ha-zhuzhu/SmartDiet/Device/Schematic/BOM.xlsx

Item | Quantity | Reference | Value | PCB Footprint
1 | 4 | C1,C2,C30,C32 | 10u | C0805_rola
2 | 6 | C3,C4,C29,C31,C34,C38 | 0.1u | C0805_rola
3 | 4 | C7,C8,C9,C10 | 30p | C0805_rola
4 | 6 | C11,C24,C27,C28,C36,C37 | 100n | C0805_rola
5 | 2 | C19,C20 | 12p | C0805_rola
6 | 2 | C21,C33 | 1n | C0805_rola
7 | 2 | C22,C23 | 20p | C0805_rola
8 | 3 | C25,C39,C40 | 1u | C0805_rola
9 | 3 | D1,D2,D4 | SK14 | DO214
10 | 1 | D3 | RED | led_3mm_rola
11 | 1 | J1 | CON6 | hdr_1x6_rola
12 | 1 | J2 | 20279-001E-01 | IPEX_20279-001E-01
13 | 1 | J3 | MicroUSB | ZX62D-B-5P8_30__HIR
14 | 2 | J4,J7 | BAT | hdr_1x2_rola
15 | 1 | J5 | LCD | TE_103336-5
16 | 4 | J8,J9,J10,J11 | CON1 | mhole_32mm_rola
17 | 1 | J12 | CON6A | header_3x2_100mil
18 | 1 | L1 | Ferrite | R0805_rola
19 | 1 | Q1 | SS8550 | sot23_rola
20 | 1 | Q2 | SS8050 | sot23_rola
21 | 1 | Q3 | AO3401A | sot23_rola
22 | 1 | Q5 | AO3415 | sot23_rola
23 | 1 | R5 | 8.2k | R0805_rola
24 | 1 | R6 | 12k | R0805_rola
25 | 9 | R7,R18,R21,R28,R29,R30,R31,R32,R34 | 1k | R0805_rola
26 | 3 | R10,R12,R33 | 22 | R0805_rola
27 | 1 | R13 | 47k | R0805_rola
28 | 2 | R16,R27 | 10k | R0805_rola
29 | 1 | R17 | 51k | R0805_rola
30 | 3 | R19,R26,R35 | 100k | R0805_rola
31 | 1 | R22 | 33k | R0805_rola
32 | 2 | R23,R24 | 4.7k | R0805_rola
33 | 1 | R25 | 510k | R0805_rola
34 | 1 | R38 | 68k/NC | R0805_rola
35 | 1 | R39 | 300k/FB | R0805_rola
36 | 1 | R40 | 20k | R0805_rola
37 | 1 | R41 | 0 | R0805_rola
38 | 5 | R42,R43,R44,R45,R46 | NC | R0805_rola
39 | 1 | SIM1 | SIM_CARD | GCT_SIM7200-6-0-18-00-X_REV
40 | 1 | SW1 | SW PUSHBUTTON | pushbutton_rola
41 | 1 | SW2 | SW PUSHBUTTON | SW_1-1825027-1
42 | 1 | S1 | OS102011MS2QN1 | SW_OS102011MS2QN1
43 | 1 | U1 | HX711 | SOIC127P600X160-16N
44 | 1 | U2 | BC26 | BC26
45 | 1 | U5 | STM32L053C6 | LQFP48-7x7mm
46 | 1 | U6 | MP26028EQ | IC10_MP26028_MNP-L
47 | 1 | U9 | TPS7A2033PDBVR | DBV0005A-IPC_B
48 | 1 | Y1 | 8M | osc5032s2pin_rola
49 | 1 | Y2 | 32.768k | XTAL_ABS07-32768KHZ-T
50 | 1 |  | LCD
51 | 1 |  | 3kg悬臂梁式传感器
