ha-zhuzhu/SmartDiet/Device/Schematic/cyberbalance_3d_step_lib/USB3076-30-A--3DModel-STEP-56544.STEP

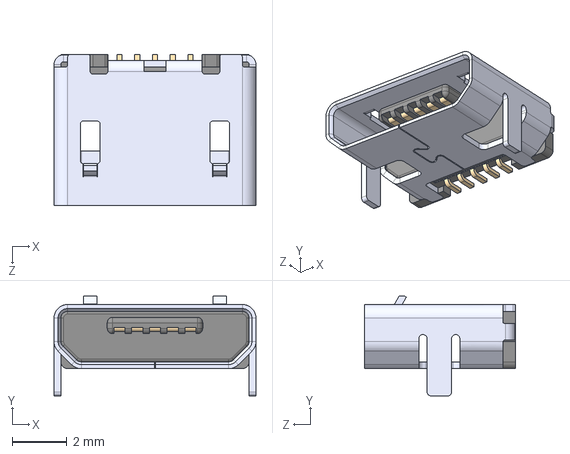
[picture p5: CAD file, 2021-05-22]
Device/Schematic/cyberbalance_3d_step_lib/USB3076-30-A--3DModel-STEP-56544.STEP
7.40 x 3.66 x 5.55 mm
