ha-zhuzhu/SmartDiet/(list of files, cad)

Other CAD files:
Device/Schematic/cyberbalance_footprint_lib/DO214.psm
Device/Schematic/cyberbalance_footprint_lib/bc26.psm
Device/Schematic/cyberbalance_footprint_lib/c0805_rola.psm
Device/Schematic/cyberbalance_footprint_lib/conn_5p8_30_.psm
Device/Schematic/cyberbalance_footprint_lib/dbv0005a-ipc_b.psm
Device/Schematic/cyberbalance_footprint_lib/gct_sim7200-6-0-18-00-x_rev.psm
Device/Schematic/cyberbalance_footprint_lib/gct_usb3076-xx-x_revc.psm
Device/Schematic/cyberbalance_footprint_lib/hdr_1x2_rola.psm
Device/Schematic/cyberbalance_footprint_lib/hdr_1x6_100mil.psm
Device/Schematic/cyberbalance_footprint_lib/hdr_1x6_rola.psm
Device/Schematic/cyberbalance_footprint_lib/hdr_2x3_100mil_th.psm
Device/Schematic/cyberbalance_footprint_lib/header_3x2_100mil.psm
Device/Schematic/cyberbalance_footprint_lib/hrs_zx62d-b-5p8.psm
Device/Schematic/cyberbalance_footprint_lib/ic10_mp26028_mnp-l.psm
Device/Schematic/cyberbalance_footprint_lib/ipex_20279-001e-01.psm
Device/Schematic/cyberbalance_footprint_lib/led_3mm_rola.psm
Device/Schematic/cyberbalance_footprint_lib/lqfp48-7x7mm.psm
Device/Schematic/cyberbalance_footprint_lib/mhfi_rece_ipx.psm
Device/Schematic/cyberbalance_footprint_lib/mhole_32mm_rola.psm
Device/Schematic/cyberbalance_footprint_lib/osc5032s2pin_rola.psm
Device/Schematic/cyberbalance_footprint_lib/pushbutton_rola.psm
Device/Schematic/cyberbalance_footprint_lib/r0805_rola.psm
Device/Schematic/cyberbalance_footprint_lib/samtec_rsp-122811-01.psm
Device/Schematic/cyberbalance_footprint_lib/soic127p600x160-16n.psm
Device/Schematic/cyberbalance_footprint_lib/sot23_6_rola.psm
Device/Schematic/cyberbalance_footprint_lib/sot23_rola.psm
Device/Schematic/cyberbalance_footprint_lib/sot95p275x135-6.psm
Device/Schematic/cyberbalance_footprint_lib/sw_1-1825027-1.psm
Device/Schematic/cyberbalance_footprint_lib/sw_os102011ms2qn1.psm
Device/Schematic/cyberbalance_footprint_lib/te_103336-5.psm
Device/Schematic/cyberbalance_footprint_lib/xtal_abs07-32768khz-t.psm
Device/Schematic/cyberbalance_footprint_lib/zx62d-b-5p8_30__hir.psm
