ha-zhuzhu/SmartDiet/Device/Schematic/allegro/stepFacetFiles4Map/stepFileInfo.txt

#STEP_FILE ! FILE_SIZE ! MOD_TIME

USB3076-30-A--3DModel-STEP-56544.STEP ! 1007054 ! 1620821139
507302B00000G--3DModel-STEP-56544.STEP ! 207014 ! 1568096060
