ha-zhuzhu/SmartDiet/Device/Schematic/PCB.pdf

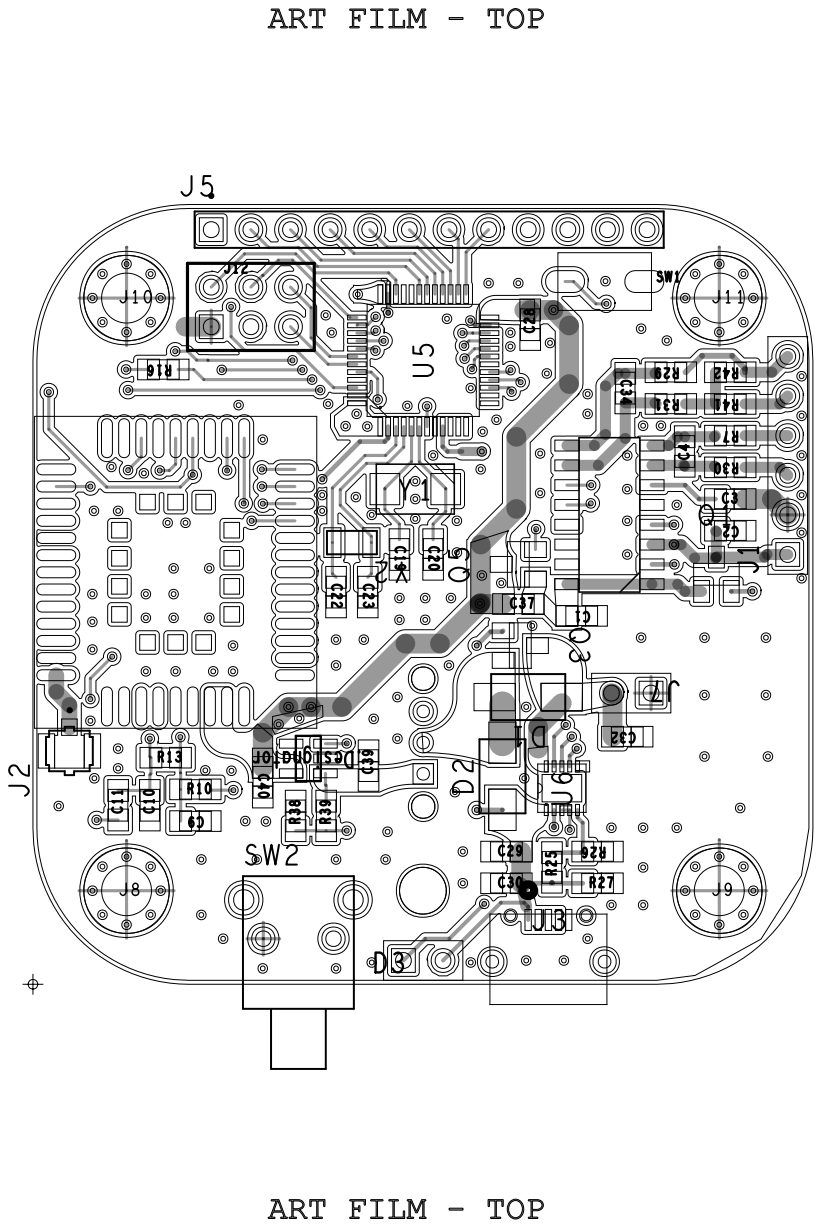
[picture p6: page 1]

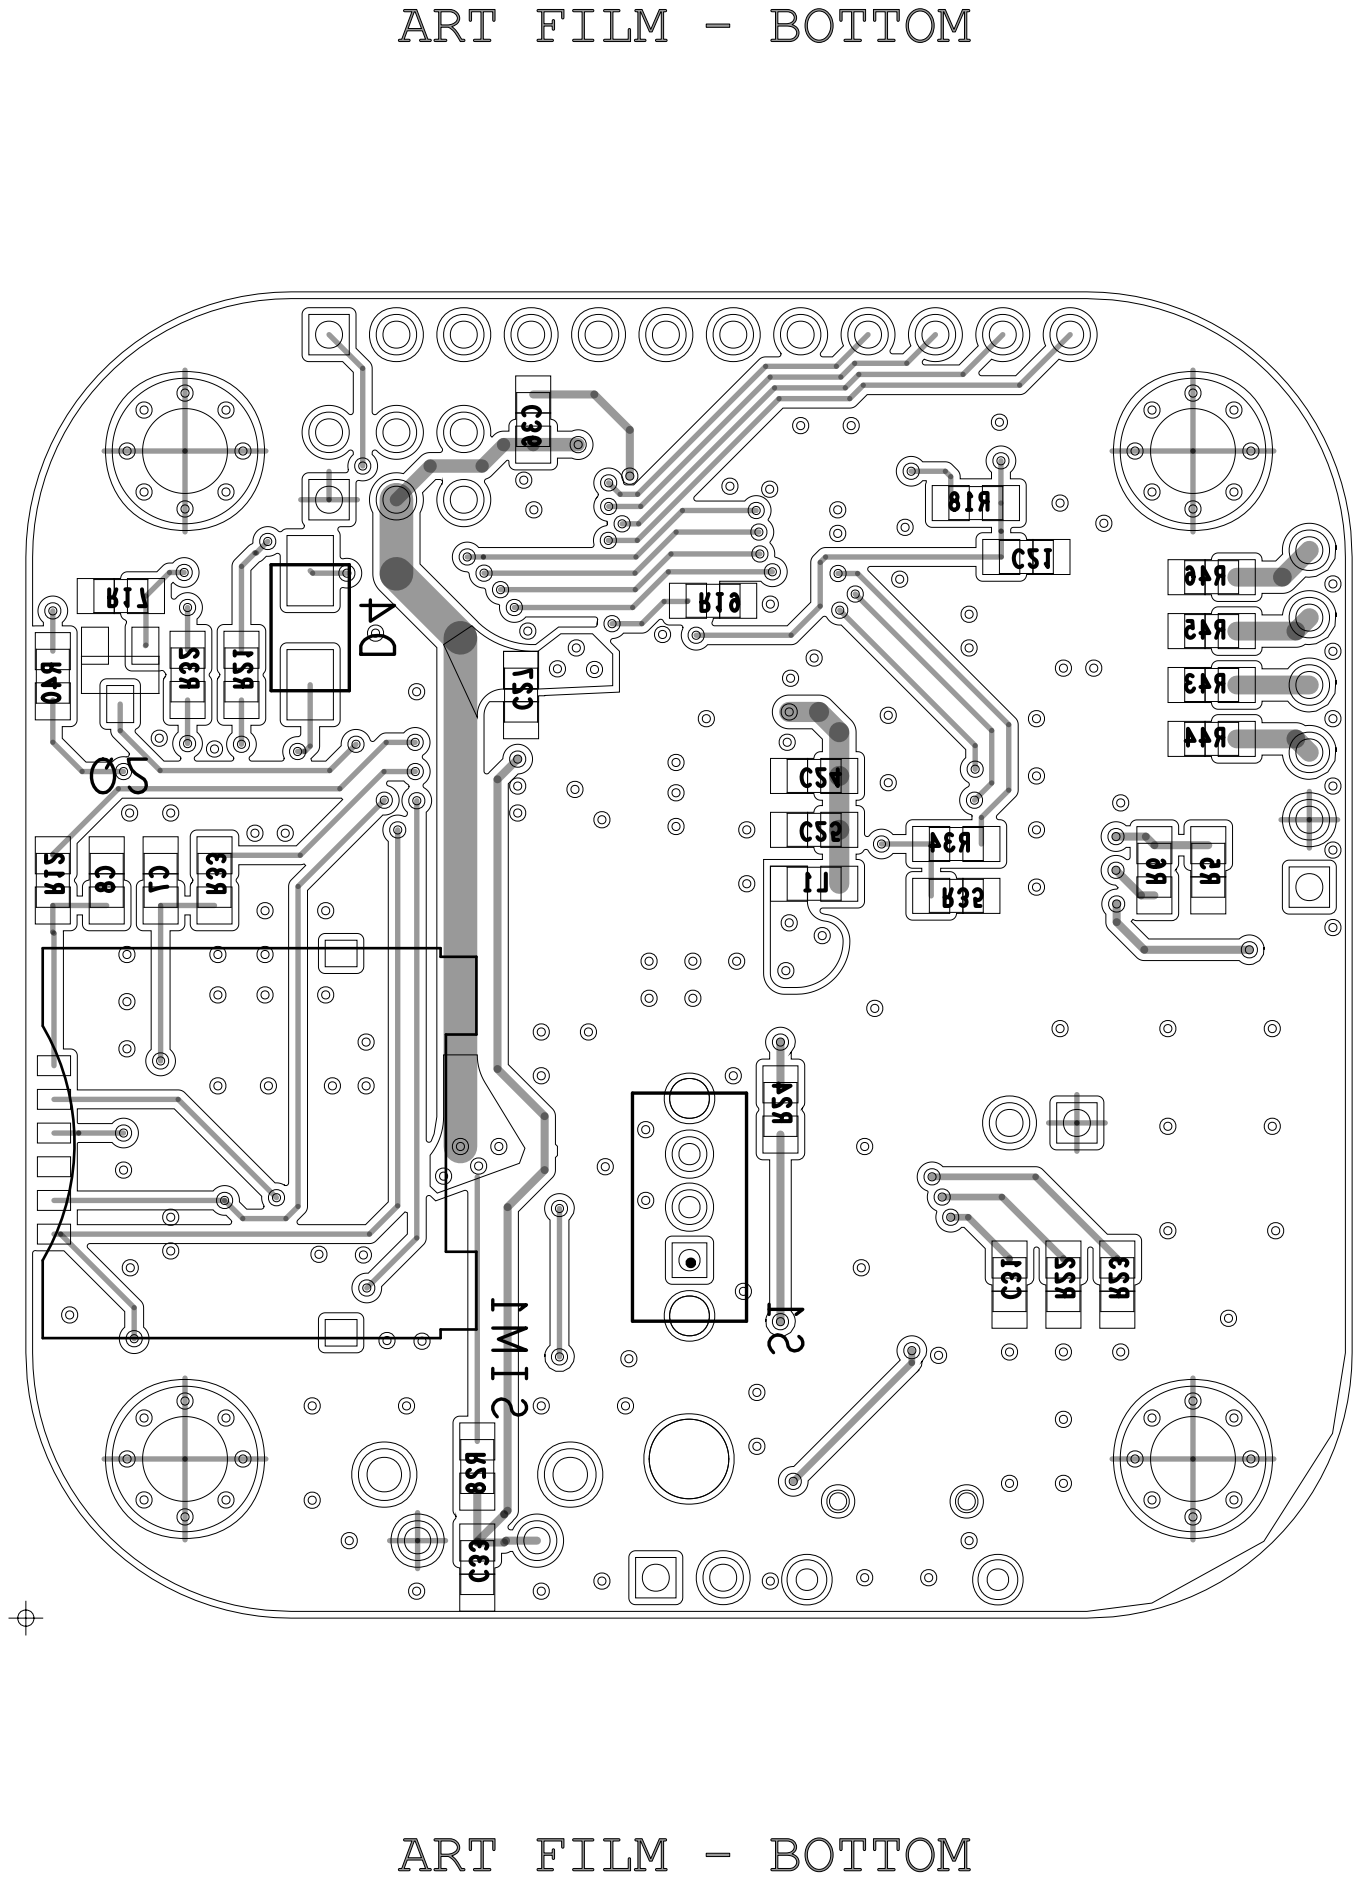
[picture p7: page 2]

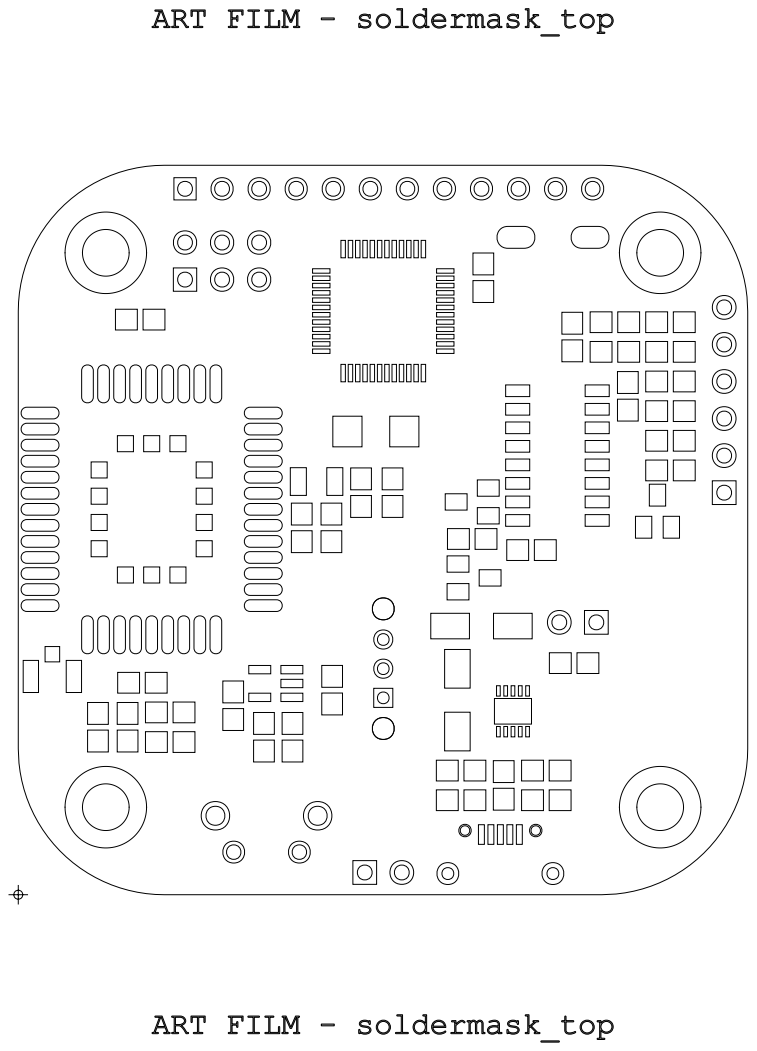
[picture p8: page 3]
ART FILM - soldermask_top

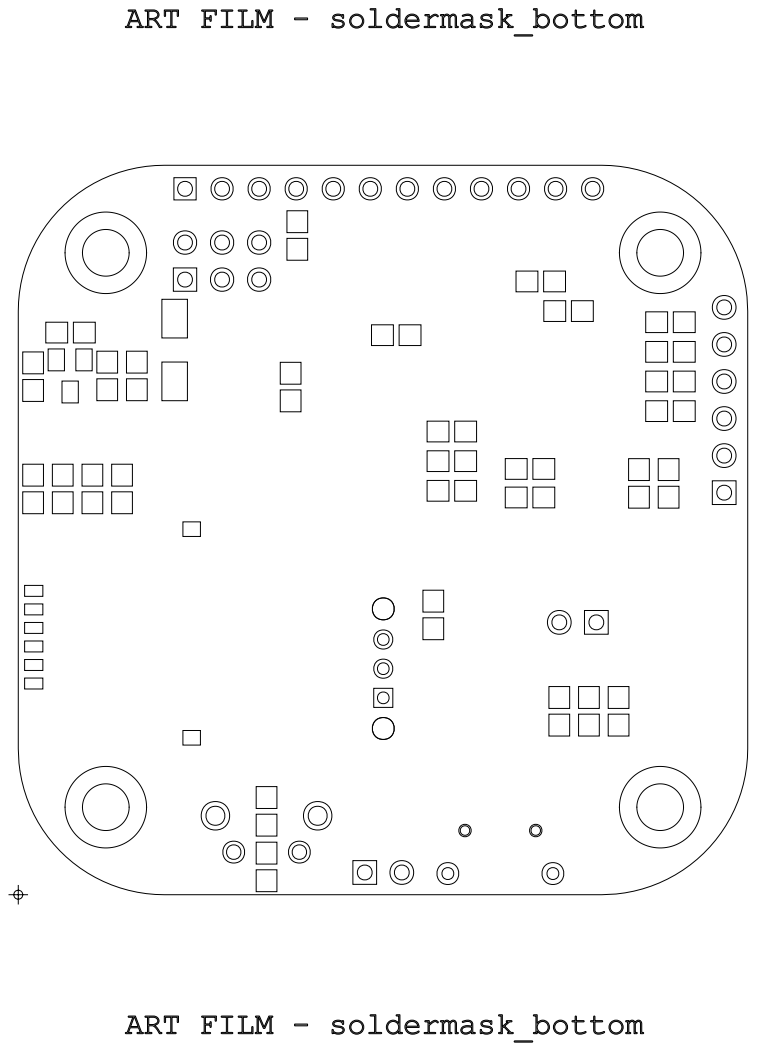
[picture p9: page 4]
ART FILM - soldermask_bottom

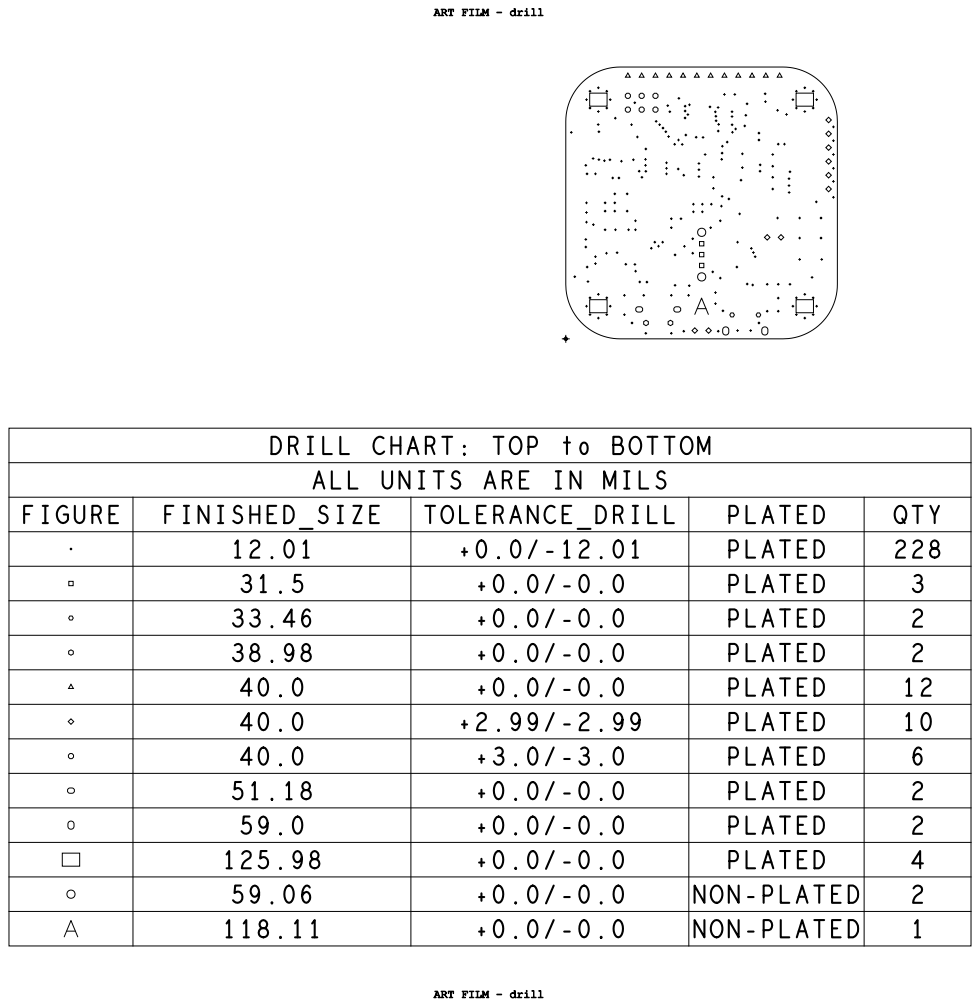
[picture p10: page 5]
FIGURE; FINISHED_SIZE; DRILL CHART:; TOP to BOTTOM; TOLERANCE_DRILL; NON-PLATED; PLATED; QTY

ART FILM - drill

ALL UNITS ARE IN MILS

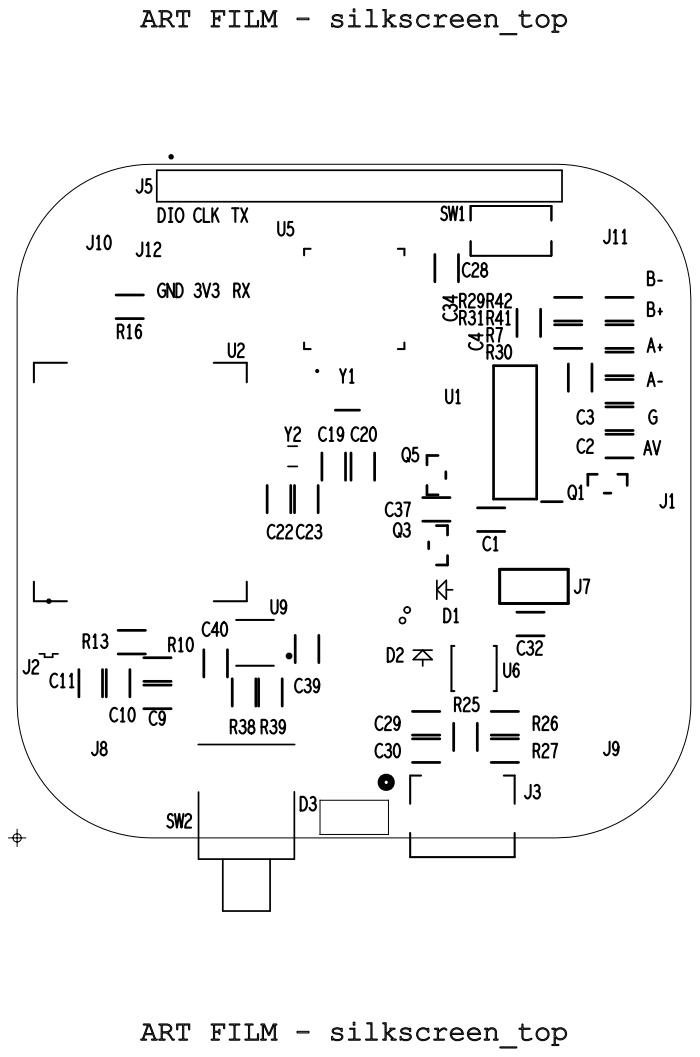
[picture p11: page 6]

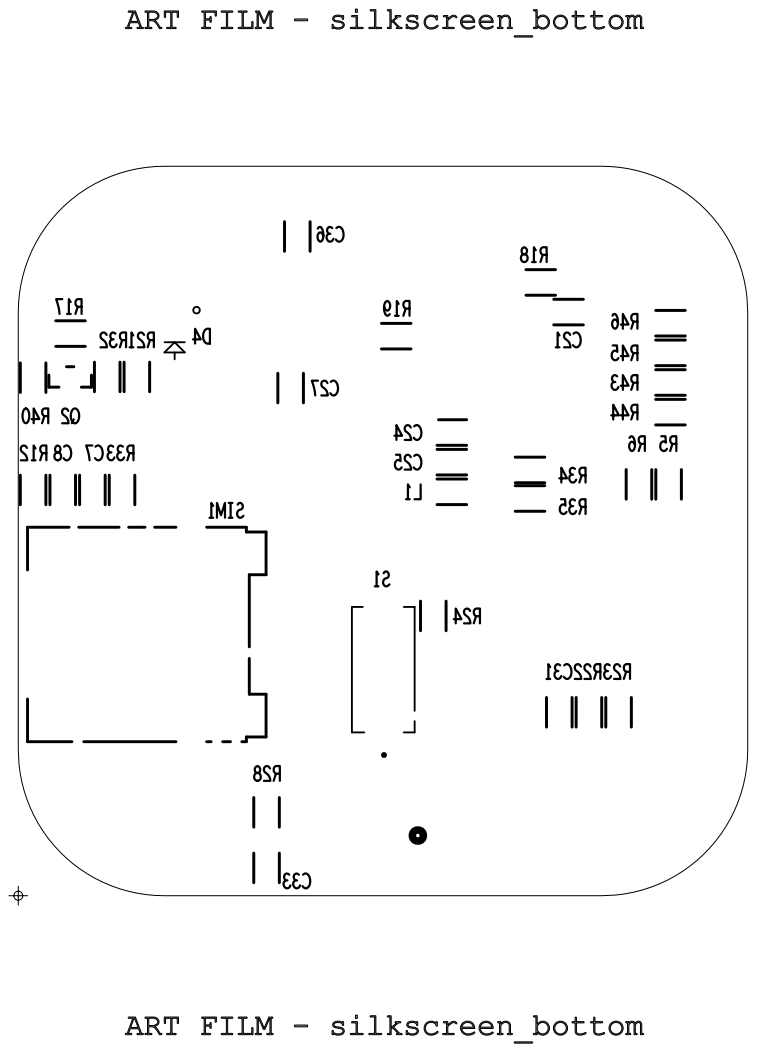
[picture p12: page 7]

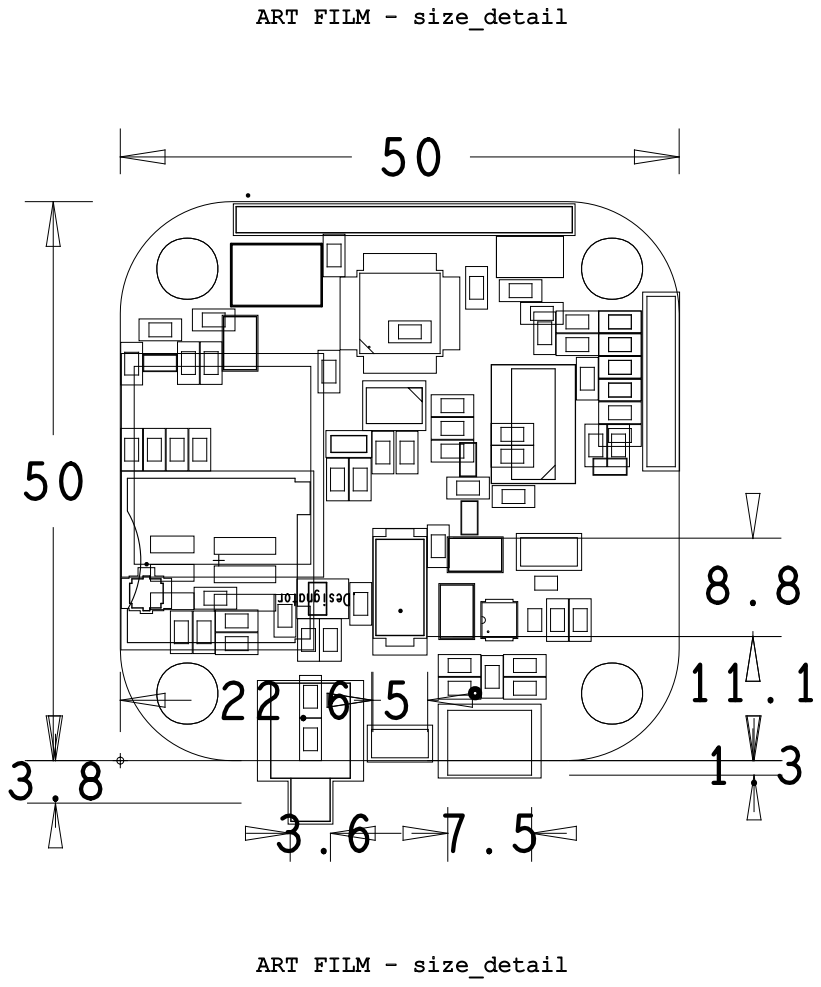
[picture p13: page 8]
ART FILM - size_detail
