ha-zhuzhu/SmartDiet/(list of files, drawings)

Other design files:
Device/Schematic/CYBERBALANCE.DSN
Device/Schematic/cyberbalance.opj
