ha-zhuzhu/SmartDiet/Device/Schematic/allegro/nc_param.txt

INTEGER-PLACES         3
DECIMAL-PLACES         6
X-OFFSET               0.000000
Y-OFFSET               0.000000
FEEDRATE               1
COORDINATES            ABSOLUTE
OUTPUT-UNITS           ENGLISH
TOOL-ORDER             INCREASING
REPEAT-CODES           YES
SUPPRESS-LEAD-ZEROES   NO
SUPPRESS-TRAIL-ZEROES  YES
SUPPRESS-EQUAL         YES
TOOL-SELECT            NO
OPTIMIZE_DRILLING      NO
ENHANCED_EXCELLON      YES
HEADER                 none
LEADER                 12
CODE                   ASCII
SEPARATE               NO
SEPARATE-ROUTING       NO
DRILLING               LAYER-PAIR
BACKDRILL              NO
COUNTER                NO
CAVITY                 NO
TOLERANCE_DRILL        YES
TOLERANCE_TRAVEL       YES
TOOL_SIZE              YES
ROTATION               YES
NON_STANDARD           YES
TOTAL_DRILL            NO
SEPARATE_SLOT          NO
SUPPRESS_TOLERANCE     YES
SUPPRESS_TOOLSIZE      YES
SUPPRESS_ROTATION      YES
