ha-zhuzhu/SmartDiet/Device/Code/STM32L053/HARDWARE/Src/lcd.c

#include "lcd.h"

#define ASCII_CHAR_0 0x30 /* 0 */

LCD_HandleTypeDef hlcd;

/**
================================================================================
                                                            GLASS LCD MAPPING
================================================================================
LCD allows to display informations on four 8-segment digits:

    1      2      3      4
 ----   ----   ----   ----
 |  |   |  | o |  |   |  |
 ----   ----   ----   ----
 |  |   |  | o |  |   |  |
 ---- * ---- * ---- * ----
 
LCD segment mapping:
--------------------
    ---A---        _ 
    |     |    P1 |_|
    F     B          
    |     |        _ 
    ---G---    P1 |_|
    |     |          
    E     C          
    |     |    _ 
    ---D---   |_| P(2,3,4)
An LCD character coding is based on the following matrix:
COM          0   1   2   3
SEG(n)     { A , F , E , P }
SEG(n+1)   { B , G , C , D }

The character 'A' for example is:
    -------------------------------
LSB        { 1 , 1 , 1 , 0 }
MSB        { 1 , 1 , 1 , 0 }
          -------------------
    'A' =  0xEE   hex
*/
/* Constant table for number '0' --> '9' 'a' --> 'f' */
const uint16_t NumberMap[16] =
    {
        /* 0      1      2      3      4      5      6      7      8      9      a      b      c      d      e      f  */
        0xBE, 0xA0, 0xDA, 0xF8, 0xE4, 0x7C, 0x7E, 0xA8, 0xFE, 0xFC, 0xEE, 0x76, 0x1E, 0xF2, 0x5E, 0x4E};
const uint16_t ErrorCode[3] =
    {
        /* E     r     o  */
        0x5E, 0x42, 0x72};
const uint16_t dot = 0x01;
const uint16_t minus = 0x40;
uint32_t Digit[2]; /* Digit frame buffer */
uint32_t DigitData[8];

/**
    * @brief  Configure the LCD Blink mode and Blink frequency.
    * @param  BlinkMode: specifies the LCD blink mode.
    *   This parameter can be one of the following values:
    *     @arg LCD_BLINKMODE_OFF:           Blink disabled
    *     @arg LCD_BLINKMODE_SEG0_COM0:     Blink enabled on SEG[0], COM[0] (1 pixel)
    *     @arg LCD_BLINKMODE_SEG0_ALLCOM:   Blink enabled on SEG[0], all COM (up to 8 
    *                                       pixels according to the programmed duty)
    *     @arg LCD_BLINKMODE_ALLSEG_ALLCOM: Blink enabled on all SEG and all COM 
    *                                       (all pixels)
    * @param  BlinkFrequency: specifies the LCD blink frequency.
    *     @arg LCD_BLINKFREQUENCY_DIV8:    The Blink frequency = fLcd/8
    *     @arg LCD_BLINKFREQUENCY_DIV16:   The Blink frequency = fLcd/16
    *     @arg LCD_BLINKFREQUENCY_DIV32:   The Blink frequency = fLcd/32
    *     @arg LCD_BLINKFREQUENCY_DIV64:   The Blink frequency = fLcd/64 
    *     @arg LCD_BLINKFREQUENCY_DIV128:  The Blink frequency = fLcd/128
    *     @arg LCD_BLINKFREQUENCY_DIV256:  The Blink frequency = fLcd/256
    *     @arg LCD_BLINKFREQUENCY_DIV512:  The Blink frequency = fLcd/512
    *     @arg LCD_BLINKFREQUENCY_DIV1024: The Blink frequency = fLcd/1024
    * @retval None
    */
void LCD_GLASS_BlinkConfig(void)
{
    __HAL_LCD_BLINK_CONFIG(&hlcd, LCD_BLINKMODE_ALLSEG_ALLCOM, LCD_BLINKFREQUENCY_DIV256);
}

void LCD_GLASS_BlinkDeConfig(void)
{
    __HAL_LCD_BLINK_CONFIG(&hlcd, LCD_BLINKMODE_OFF, LCD_BLINKFREQUENCY_DIV256);
}

void LCD_GLASS_Heartbeat(float src)
{
    if ((src >= -199.9 && src <= 999.9)) //均显示一位小数
        WriteFloat(src, Mode_2);
    /*
    if ((src >= 0) && (src <= 9.999))
    {
        WriteFloat(src, Mode_0);
    }
    else if (((src >= -19.99) && (src < 0)) || ((src > 9.999) && (src <= 99.99)))
    {
        WriteFloat(src, Mode_1);
    }
    else if (((src >= -199.9) && (src < -19.99)) || ((src > 99.99) && (src <= 999.9)))
    {
        WriteFloat(src, Mode_2);
    }*/
    else if (((src >= -1999) && (src < -199.9)) || ((src > 999.9) && (src <= 9999)))
    {
        WriteFloat(src, Mode_3);
    }
    else
    {
        WriteFloat(src, Mode_Err);
    }
    //HAL_Delay(150);
    //LL_mDelay(150);
    /* Update the LCD display */
    HAL_LCD_UpdateDisplayRequest(&hlcd);
}

void LCD_GLASS_Clear(void)
{
    HAL_LCD_Clear(&hlcd);
}

static void Convert(uint8_t Char, Point_Typedef Point, Minus_Typedef Minus)
{
    uint16_t ch = 0;
    uint8_t loop = 0, index = 0;
    switch (Char)
    {
    case '0':
    case '1':
    case '2':
    case '3':
    case '4':
    case '5':
    case '6':
    case '7':
    case '8':
    case '9':
        ch = NumberMap[Char - ASCII_CHAR_0];
        break;
    case 'E':
        ch = ErrorCode[0];
        break;
    case 'r':
        ch = ErrorCode[1];
        break;
    case 'o':
        ch = ErrorCode[2];
        break;
    default:
        ch = 0x00;
        break;
    }
    if (Minus == MINUS_ON)
    {
        ch |= minus;
    }
    if (Point == POINT_ON)
    {
        ch |= dot;
    }
    for (loop = 4, index = 0; index < 2; loop -= 4, index++)
    {
        Digit[index] = (ch >> loop) & 0x0f; /*To isolate the less significant digit */
    }
}

/**
PIN     1       2       3       4       5       6       7       8       9       10      11      12
COM1   COM1                             1A      1B      2A      2B      3A      3B      4A      4B
COM2           COM2                     1F      1G      2F      2G      3F      3G      4F      4G
COM3                   COM3             1E      1C      2E      2C      3E      3C      4E      4C
COM4                           COM4     1P      1D      2P      2D      3P      3D      4P      4D
*/

static void WriteFloat(float src, Mode_Typedef Mode)
{
    uint32_t data = 0x00;
    char ch[10];
    int i, j = 0;
    if (Mode == Mode_0) //((src >= 0) && (src <= 9.999))
    {
        sprintf(ch, "%5.3f", fastAbs(src));
        for (i = 0; i < strlen(ch); i++)
        {
            if (src < 0)
            {
                if (i == 0)
                {
                    Convert((uint8_t)ch[i], POINT_OFF, MINUS_ON);
                }
                else if (ch[i] == '.')
                {
                    Convert((uint8_t)ch[i + 1], POINT_ON, MINUS_OFF);
                    i += 1;
                    // +1 是因为当前数码右下角的“点”其实是和下一个数码一起管的
                    // 所以这里直接将这个点和下一个数码一起 Convert
                }
                else
                {
                    Convert((uint8_t)ch[i], POINT_OFF, MINUS_OFF);
                }
            }
            else if (ch[i] == '.')
            {
                Convert((uint8_t)ch[i + 1], POINT_ON, MINUS_OFF);
                i += 1;
            }
            else
            {
                Convert((uint8_t)ch[i], POINT_OFF, MINUS_OFF);
            }
            DigitData[j] = Digit[0];
            DigitData[j + 1] = Digit[1];
            j += 2;
        }
    }
    else if (Mode == Mode_1) //(((src >= -19.99) && (src < 0)) || ((src > 9.999) && (src <= 99.99)))
    {
        sprintf(ch, "%5.2f", fastAbs(src));
        for (i = 0; i < strlen(ch); i++)
        {
            if (src < 0)
            {
                if (i == 0)
                {
                    Convert((uint8_t)ch[i], POINT_OFF, MINUS_ON);
                }
                else if (ch[i] == '.')
                {
                    Convert((uint8_t)ch[i + 1], POINT_ON, MINUS_OFF);
                    i += 1;
                }
                else
                {
                    Convert((uint8_t)ch[i], POINT_OFF, MINUS_OFF);
                }
            }
            else if (ch[i] == '.')
            {
                Convert((uint8_t)ch[i + 1], POINT_ON, MINUS_OFF);
                i += 1;
            }
            else
            {
                Convert((uint8_t)ch[i], POINT_OFF, MINUS_OFF);
            }
            DigitData[j] = Digit[0];
            DigitData[j + 1] = Digit[1];
            j += 2;
        }
    }
    else if (Mode == Mode_2) //(((src >= -199.9) && (src < -19.99)) || ((src > 99.99) && (src <= 999.9)))
    {
        sprintf(ch, "%5.1f", fastAbs(src));
        for (i = 0; i < strlen(ch); i++)
        {
            if (src < 0)
            {
                if (i == 0)
                {
                    Convert((uint8_t)ch[i], POINT_OFF, MINUS_ON);
                }
                else if (ch[i] == '.')
                {
                    Convert((uint8_t)ch[i + 1], POINT_ON, MINUS_OFF);
                    i += 1;
                }
                else
                {
                    Convert((uint8_t)ch[i], POINT_OFF, MINUS_OFF);
                }
            }
            else if (ch[i] == '.')
            {
                Convert((uint8_t)ch[i + 1], POINT_ON, MINUS_OFF);
                i += 1;
            }
            else
            {
                Convert((uint8_t)ch[i], POINT_OFF, MINUS_OFF);
            }
            DigitData[j] = Digit[0];
            DigitData[j + 1] = Digit[1];
            j += 2;
        }
    }
    else if (Mode == Mode_3) //(((src >= -1999) && (src < -199.9)) || ((src > 999.9) && (src <= 9999)))
    {
        sprintf(ch, "%4.0f", fastAbs(src));
        for (i = 0; i < strlen(ch); i++)
        {
            if (src < 0)
            {
                if (i == 0)
                {
                    Convert((uint8_t)ch[i], POINT_OFF, MINUS_ON);
                }
                else if (ch[i] == '.')
                {
                    Convert((uint8_t)ch[i + 1], POINT_ON, MINUS_OFF);
                    i += 1;
                }
                else
                {
                    Convert((uint8_t)ch[i], POINT_OFF, MINUS_OFF);
                }
            }
            else if (ch[i] == '.')
            {
                Convert((uint8_t)ch[i + 1], POINT_ON, MINUS_OFF);
                i += 1;
            }
            else
            {
                Convert((uint8_t)ch[i], POINT_OFF, MINUS_OFF);
            }
            DigitData[j] = Digit[0];
            DigitData[j + 1] = Digit[1];
            j += 2;
        }
    }
    else
    {
        char err[5] = {' ', 'E', 'r', 'r'};
        for (i = 0; i < strlen(err); i++)
        {
            if (err[i] == '.')
            {
                Convert((uint8_t)err[i + 1], POINT_ON, MINUS_OFF);
                i += 1;
            }
            else
            {
                Convert((uint8_t)err[i], POINT_OFF, MINUS_OFF);
            }
            DigitData[j] = Digit[0];
            DigitData[j + 1] = Digit[1];
            j += 2;
        }
    }
    data = (((DigitData[1] & 0x8) >> 3) << LCD_SEG0_SHIFT) | (((DigitData[0] & 0x8) >> 3) << LCD_SEG1_SHIFT) |
           (((DigitData[3] & 0x8) >> 3) << LCD_SEG2_SHIFT) | (((DigitData[2] & 0x8) >> 3) << LCD_SEG3_SHIFT) |
           (((DigitData[5] & 0x8) >> 3) << LCD_SEG4_SHIFT) | (((DigitData[4] & 0x8) >> 3) << LCD_SEG5_SHIFT) |
           (((DigitData[7] & 0x8) >> 3) << LCD_SEG6_SHIFT) | (((DigitData[6] & 0x8) >> 3) << LCD_SEG7_SHIFT);
    HAL_LCD_Write(&hlcd, LCD_DIGIT_COM0, LCD_DIGIT_COM0_SEG_MASK, data);
    data = (((DigitData[1] & 0x4) >> 2) << LCD_SEG0_SHIFT) | (((DigitData[0] & 0x4) >> 2) << LCD_SEG1_SHIFT) |
           (((DigitData[3] & 0x4) >> 2) << LCD_SEG2_SHIFT) | (((DigitData[2] & 0x4) >> 2) << LCD_SEG3_SHIFT) |
           (((DigitData[5] & 0x4) >> 2) << LCD_SEG4_SHIFT) | (((DigitData[4] & 0x4) >> 2) << LCD_SEG5_SHIFT) |
           (((DigitData[7] & 0x4) >> 2) << LCD_SEG6_SHIFT) | (((DigitData[6] & 0x4) >> 2) << LCD_SEG7_SHIFT);
    HAL_LCD_Write(&hlcd, LCD_DIGIT_COM1, LCD_DIGIT_COM1_SEG_MASK, data);
    data = (((DigitData[1] & 0x2) >> 1) << LCD_SEG0_SHIFT) | (((DigitData[0] & 0x2) >> 1) << LCD_SEG1_SHIFT) |
           (((DigitData[3] & 0x2) >> 1) << LCD_SEG2_SHIFT) | (((DigitData[2] & 0x2) >> 1) << LCD_SEG3_SHIFT) |
           (((DigitData[5] & 0x2) >> 1) << LCD_SEG4_SHIFT) | (((DigitData[4] & 0x2) >> 1) << LCD_SEG5_SHIFT) |
           (((DigitData[7] & 0x2) >> 1) << LCD_SEG6_SHIFT) | (((DigitData[6] & 0x2) >> 1) << LCD_SEG7_SHIFT);
    HAL_LCD_Write(&hlcd, LCD_DIGIT_COM2, LCD_DIGIT_COM2_SEG_MASK, data);
    data = ((DigitData[1] & 0x1) << LCD_SEG0_SHIFT) | ((DigitData[0] & 0x1) << LCD_SEG1_SHIFT) |
           ((DigitData[3] & 0x1) << LCD_SEG2_SHIFT) | ((DigitData[2] & 0x1) << LCD_SEG3_SHIFT) |
           ((DigitData[5] & 0x1) << LCD_SEG4_SHIFT) | ((DigitData[4] & 0x1) << LCD_SEG5_SHIFT) |
           ((DigitData[7] & 0x1) << LCD_SEG6_SHIFT) | ((DigitData[6] & 0x1) << LCD_SEG7_SHIFT);
    HAL_LCD_Write(&hlcd, LCD_DIGIT_COM3, LCD_DIGIT_COM3_SEG_MASK, data);
}
/* USER CODE END 0 */

#if !defined(USE_DEVELOPMENT_BOARD)
void LCD_Init(void)
{
    hlcd.Instance = LCD;
    hlcd.Init.Prescaler = LCD_PRESCALER_128;
    hlcd.Init.Divider = LCD_DIVIDER_19;
    hlcd.Init.Duty = LCD_DUTY_1_4;
    hlcd.Init.Bias = LCD_BIAS_1_4;
    hlcd.Init.VoltageSource = LCD_VOLTAGESOURCE_EXTERNAL;
    hlcd.Init.Contrast = LCD_CONTRASTLEVEL_0;
    hlcd.Init.DeadTime = LCD_DEADTIME_0;
    hlcd.Init.PulseOnDuration = LCD_PULSEONDURATION_5;
    hlcd.Init.HighDrive = LCD_HIGHDRIVE_0;
    hlcd.Init.BlinkMode = LCD_BLINKMODE_OFF;
    hlcd.Init.BlinkFrequency = LCD_BLINKFREQUENCY_DIV512;
    hlcd.Init.MuxSegment = LCD_MUXSEGMENT_DISABLE;
    if (HAL_LCD_Init(&hlcd) != HAL_OK)
    {
        Error_Handler();
    }
}
#else
void LCD_Init(void)
{
    hlcd.Instance = LCD;
    hlcd.Init.Prescaler = LCD_PRESCALER_4;
    hlcd.Init.Divider = LCD_DIVIDER_20;
    hlcd.Init.Duty = LCD_DUTY_1_4;
    hlcd.Init.Bias = LCD_BIAS_1_3;
    hlcd.Init.VoltageSource = LCD_VOLTAGESOURCE_EXTERNAL;
    hlcd.Init.Contrast = LCD_CONTRASTLEVEL_0;
    hlcd.Init.DeadTime = LCD_DEADTIME_0;
    hlcd.Init.PulseOnDuration = LCD_PULSEONDURATION_5;
    hlcd.Init.HighDrive = LCD_HIGHDRIVE_0;
    hlcd.Init.BlinkMode = LCD_BLINKMODE_OFF;
    hlcd.Init.BlinkFrequency = LCD_BLINKFREQUENCY_DIV512;
    hlcd.Init.MuxSegment = LCD_MUXSEGMENT_DISABLE;
    if (HAL_LCD_Init(&hlcd) != HAL_OK)
    {
        Error_Handler();
    }
}
#endif

void LCD_Deinit(void)
{
    HAL_LCD_DeInit(&hlcd);
}

void HAL_LCD_MspInit(LCD_HandleTypeDef *lcdHandle)
{

    GPIO_InitTypeDef GPIO_InitStruct = {0};
    if (lcdHandle->Instance == LCD)
    {
        /* LCD clock enable */
        __HAL_RCC_LCD_CLK_ENABLE();

        __HAL_RCC_GPIOB_CLK_ENABLE();
        __HAL_RCC_GPIOA_CLK_ENABLE();
        /**LCD GPIO Configuration
    PB12     ------> LCD_SEG12
    PB13     ------> LCD_SEG13
    PB14     ------> LCD_SEG14
    PB15     ------> LCD_SEG15
    PA8     ------> LCD_COM0
    PA9     ------> LCD_COM1
    PA10     ------> LCD_COM2
    PA15     ------> LCD_SEG17
    PB3     ------> LCD_SEG7
    PB4     ------> LCD_SEG8
    PB5     ------> LCD_SEG9
    PB9     ------> LCD_COM3
    */
        GPIO_InitStruct.Pin = GPIO_PIN_12 | GPIO_PIN_13 | GPIO_PIN_14 | GPIO_PIN_15 | GPIO_PIN_3 | GPIO_PIN_4 | GPIO_PIN_5 | GPIO_PIN_9;
        GPIO_InitStruct.Mode = GPIO_MODE_AF_PP;
        GPIO_InitStruct.Pull = GPIO_NOPULL;
        GPIO_InitStruct.Speed = GPIO_SPEED_FREQ_LOW;
        GPIO_InitStruct.Alternate = GPIO_AF1_LCD;
        HAL_GPIO_Init(GPIOB, &GPIO_InitStruct);

        GPIO_InitStruct.Pin = GPIO_PIN_8 | GPIO_PIN_9 | GPIO_PIN_10 | GPIO_PIN_15;
        GPIO_InitStruct.Mode = GPIO_MODE_AF_PP;
        GPIO_InitStruct.Pull = GPIO_NOPULL;
        GPIO_InitStruct.Speed = GPIO_SPEED_FREQ_LOW;
        GPIO_InitStruct.Alternate = GPIO_AF1_LCD;
        HAL_GPIO_Init(GPIOA, &GPIO_InitStruct);
    }
}

void HAL_LCD_MspDeInit(LCD_HandleTypeDef *lcdHandle)
{

    if (lcdHandle->Instance == LCD)
    {
        /* Peripheral clock disable */
        __HAL_RCC_LCD_CLK_DISABLE();

        /**LCD GPIO Configuration
    PB12     ------> LCD_SEG12
    PB13     ------> LCD_SEG13
    PB14     ------> LCD_SEG14
    PB15     ------> LCD_SEG15
    PA8     ------> LCD_COM0
    PA9     ------> LCD_COM1
    PA10     ------> LCD_COM2
    PA15     ------> LCD_SEG17
    PB3     ------> LCD_SEG7
    PB4     ------> LCD_SEG8
    PB5     ------> LCD_SEG9
    PB9     ------> LCD_COM3
    */
        HAL_GPIO_DeInit(GPIOB, GPIO_PIN_12 | GPIO_PIN_13 | GPIO_PIN_14 | GPIO_PIN_15 | GPIO_PIN_3 | GPIO_PIN_4 | GPIO_PIN_5 | GPIO_PIN_9);

        HAL_GPIO_DeInit(GPIOA, GPIO_PIN_8 | GPIO_PIN_9 | GPIO_PIN_10 | GPIO_PIN_15);
    }
}
