ha-zhuzhu/SmartDiet/Device/Code/STM32F401/HARDWARE/TIMER/timer.c

#include "timer.h"
#include "usart.h"
#include "stm32f4xx_tim.h"
#include "bc28.h"
unsigned char Timeout;
unsigned char restflag;
//////////////////////////////////////////////////////////////////////////////////	 //////////////////////////////////////////////////////////////////////////
extern BC28 BC28_Status;
//通用定时器3中断初始化
//这里时钟选择为APB1的2倍，而APB1为36M
//arr：自动重装值。
//psc：时钟预分频数
//这里使用的是定时器3!
void TIM3_Int_Init(u16 arr, u16 psc)
{
    TIM_TimeBaseInitTypeDef TIM_TimeBaseStructure;
    NVIC_InitTypeDef NVIC_InitStructure;

    RCC_APB1PeriphClockCmd(RCC_APB1Periph_TIM3, ENABLE); //时钟使能

    TIM_TimeBaseStructure.TIM_Period = arr;                     //设置在下一个更新事件装入活动的自动重装载寄存器周期的值	 计数到5000为500ms
    TIM_TimeBaseStructure.TIM_Prescaler = psc;                  //设置用来作为TIMx时钟频率除数的预分频值  10Khz的计数频率
    TIM_TimeBaseStructure.TIM_ClockDivision = 0;                //设置时钟分割:TDTS = Tck_tim
    TIM_TimeBaseStructure.TIM_CounterMode = TIM_CounterMode_Up; //TIM向上计数模式
    TIM_TimeBaseInit(TIM3, &TIM_TimeBaseStructure);             //根据TIM_TimeBaseInitStruct中指定的参数初始化TIMx的时间基数单位

    TIM_ITConfig(TIM3, TIM_IT_Update, ENABLE); //使能指定的TIM3中断,允许更新中断

    NVIC_InitStructure.NVIC_IRQChannel = TIM3_IRQn;           //TIM3中断
    NVIC_InitStructure.NVIC_IRQChannelPreemptionPriority = 0; //先占优先级0级
    NVIC_InitStructure.NVIC_IRQChannelSubPriority = 3;        //从优先级3级
    NVIC_InitStructure.NVIC_IRQChannelCmd = ENABLE;           //IRQ通道被使能
    NVIC_Init(&NVIC_InitStructure);                           //根据NVIC_InitStruct中指定的参数初始化外设NVIC寄存器

    TIM_Cmd(TIM3, DISABLE); //不使能TIMx外设
}
void TIM4_Int_Init(u16 arr, u16 psc)
{
    TIM_TimeBaseInitTypeDef TIM_TimeBaseStructure;
    NVIC_InitTypeDef NVIC_InitStructure;

    RCC_APB1PeriphClockCmd(RCC_APB1Periph_TIM4, ENABLE); //时钟使能

    TIM_TimeBaseStructure.TIM_Period = arr;                     //设置在下一个更新事件装入活动的自动重装载寄存器周期的值	 计数到5000为500ms
    TIM_TimeBaseStructure.TIM_Prescaler = psc;                  //设置用来作为TIMx时钟频率除数的预分频值  10Khz的计数频率
    TIM_TimeBaseStructure.TIM_ClockDivision = 0;                //设置时钟分割:TDTS = Tck_tim
    TIM_TimeBaseStructure.TIM_CounterMode = TIM_CounterMode_Up; //TIM向上计数模式
    TIM_TimeBaseInit(TIM4, &TIM_TimeBaseStructure);             //根据TIM_TimeBaseInitStruct中指定的参数初始化TIMx的时间基数单位

    TIM_ITConfig(TIM4, TIM_IT_Update, ENABLE); //使能指定的TIM4中断,允许更新中断

    NVIC_InitStructure.NVIC_IRQChannel = TIM4_IRQn;           //TIM4中断
    NVIC_InitStructure.NVIC_IRQChannelPreemptionPriority = 3; //先占优先级0级
    NVIC_InitStructure.NVIC_IRQChannelSubPriority = 3;        //从优先级3级
    NVIC_InitStructure.NVIC_IRQChannelCmd = ENABLE;           //IRQ通道被使能
    NVIC_Init(&NVIC_InitStructure);                           //根据NVIC_InitStruct中指定的参数初始化外设NVIC寄存器

    TIM_Cmd(TIM4, ENABLE); //使能TIMx外设
}
//定时器3中断服务程序
void TIM3_IRQHandler(void) //TIM3中断
{
    if (TIM_GetITStatus(TIM3, TIM_IT_Update) != RESET) //检查指定的TIM中断发生与否:TIM 中断源
    {
        TIM_ClearITPendingBit(TIM3, TIM_IT_Update); //清除TIMx的中断待处理位:TIM 中断源
        Timeout++;

        if (Timeout >= 30) //300ms内没有数据，表明模块休眠了。
        {
            Timeout = 0;
            restflag = 1;           //复位标志将模块复位
            TIM_Cmd(TIM3, DISABLE); //不使能TIMx外设
        }
    }
}

//定时器4中断服务程序
void TIM4_IRQHandler(void) //TIM4中断
{
    static u8 i = 0;
    if (TIM_GetITStatus(TIM4, TIM_IT_Update) != RESET) //检查指定的TIM中断发生与否:TIM 中断源
    {
        TIM_ClearITPendingBit(TIM4, TIM_IT_Update); //清除TIMx的中断待处理位:TIM 中断源
    }
}
