ha-zhuzhu/SmartDiet/Device/Code/STM32F401/USER/HX711.h

#ifndef __HX711_H
#define __HX711_H

#include "sys.h"

#define HX711_SCK PAout(6)// PA6 D12
#define HX711_DOUT PAin(7)// PA7 D11


extern void Init_HX711pin(void);
extern u32 HX711_Read(void);
extern void Get_Maopi(void);
extern void Get_Weight(void);

extern u32 HX711_Buffer;
extern u32 Weight_Maopi;
extern s32 Weight_Shiwu;
extern u8 Flag_Error;

#endif
