ha-zhuzhu/SmartDiet/(commit log)

2021-04-17 LED function
2021-04-27 Schematic Demo
    [DEMO.DSN, DESIGN1.DSN, Design1.opj, demo.opj]
2021-05-22 HX711 test on STM32F401
2021-05-22 Schematic and PCB design
    [CYBERBALANCE.DSN, CyberBalance.brd, DEMO.DSN, DESIGN1.DSN, DO214.psm, Design1.opj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]
2021-05-23 usart on STM32L0
2021-05-28 SCH & PCB bug fixed
    [CYBERBALANCE.DSN, CyberBalance.brd, conn_5p8_30_.psm, cyberbalance.opj, hrs_zx62d-b-5p8.psm, nc_param.txt, zx62d-b-5p8_30__hir.psm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]
2021-06-11 Add HX711 filter and debug
2021-06-12 Low power mode test and debug
2022-03-18 readme update
    [BOM.xlsx, BOM.xlsx, cyberbalance.opj]
